jyxddd/open-duck-mini-notes/docs/超声波避障记录.md

# 超声波避障记录

[English version](ultrasonic_obstacle_avoidance.md)

用一个 US-100 超声波测距模块，让 Open Duck 走路时不撞东西。2026-10-27 到 11-03。

## 现状（2026-11-03）

- 超声波装在头上，跟着头转，起步前可以左右看。
- 按住前进键不放，它会按"预判 + 边走边看"自己决定什么时候停下重新看，不再一路走到底。
- 实测：对着 1.9 m 外的墙按住前进，两次都没撞上。第一版停得太远（离墙约 40～50 cm），晚上测改近后的版本（走到约 20 cm 停下）。

## 硬件

- US-100 用串口模式（背面跳线帽插上），3.3 V 供电，输出也是 3.3 V，可以直接接树莓派，不用分压。
- 接线：VCC → 3.3 V（17 脚），Trig/Tx → GPIO15 RXD（10 脚），Echo/Rx → GPIO14 TXD（8 脚），GND → 25 脚。
- 树莓派要开串口、关掉串口控制台：`/boot/firmware/config.txt` 加 `enable_uart=1`，`cmdline.txt` 删掉 `console=serial0,115200`。
- 协议：9600 波特率，发 `0x55` 回 2 字节距离（毫米）；发 `0x50` 回 1 字节温度（+45）。代码：`robot_mjlab/us100.py`，每秒读 10 次。

## 踩过的坑

1. **VCC 和 GND 接反了**，读回 0 字节。换过来就好了，模块没烧。
2. **近距离有假读数。** 真实 3～10 cm 时，会混进 20 cm、26 cm 的假读数，取中位数时假读数反而赢。解决：`nearest()` 取最近 0.8 秒里第二小的读数，要两个低读数才算数。
3. **经常收不到回声。** 软的（沙发、布）、斜的、细的（桌腿）东西，声波要么被吸收，要么被反射走。11-03 的日志里，走路时常常连续 2～4 秒没有有效读数，站着时最长 50 多秒。**以前把"没读数"当成"前面没东西"，按住前进键会一直走过去撞上。** 这是改成预判的原因。
4. **装在头上只看得到约 0.4 m 高度。** 低矮的东西（拖鞋、门槛）看不到。
5. **停车有惯性。** 从发出停止到真正停下约 0.7 秒，会再走 5～8 cm。

## 现在的逻辑（`robot_mjlab/duck_server.py`）

**近距离保护（一直生效，边走边转也算）：**

| 参数 | 值 | 作用 |
| --- | --- | --- |
| 减速区 | 60 cm → 15 cm | 速度从 100% 线性降到 60% |
| 停车线 | 15 cm | 连续 0.2 秒都近就停 |
| 锁存 | 0.5 秒 | 读数在停车线附近闪烁时不会又走起来 |
| 解除 | 20 cm | 停下后要大于 20 cm 才允许再前进 |

原地转向不受限制，方便转开。

**起步扫描：** 往前走之前，头依次转向左、右、前，每个方向停 1.3 秒读距离。前方小于 25 cm 就拒绝前进。10 秒内刚扫描过就不再扫。

**预判 + 边走边看（11-03 新加）：** 扫描完记下前方距离，算出"能走多远"＝前方距离 − 20 cm（没回声时按 80 cm 算，一次最多信 1.5 m）。走路时用指令速度累加已走的距离（指令速度比真实速度快，所以估得偏多、停得偏早，偏安全）。以下任一情况就停下重新扫描：

| 条件 | 说明 |
| --- | --- |
| 走完了能走的距离 | 中途没回声时，就靠这一条 |
| 读到前方不到 50 cm，而且比预判近 15 cm 以上 | 突然冒出来的东西；读数和预判对得上（就是那面墙）就接着走近 |
| 方向比扫描时偏了 45° 以上 | 转过弯再直走，之前看到的距离不算数 |

边走边读到更远的空地，就把"能走多远"往后延，所以对着很远的空地它会一直走，不会无故停。

## 测试

单元测试（`_rescan_reason`，9 种情况，余量 20 cm）：

| 情况 | 结果 |
| --- | --- |
| 前方 1.0 m，走路时一直没回声 | 走 0.80 m 停下重看 |
| 扫描时前方没回声，之后也没有 | 走 0.60 m 停下重看 |
| 前方 1.2 m 的墙，边走边读到 | 走 1.0 m（离墙 20 cm）停下重看 |
| 前方 2 m，一直读到 2 m | 不停 |
| 走 0.3 m 后冒出 45 cm 的椅子 | 马上停下重看 |
| 扫描后转过了 60° | 马上重看 |
| 边走边转，没回声，前方 1.0 m | 走 0.80 m 停下重看 |
| 扫描看到 45 cm，走近时读到同一面墙 | 走 0.25 m 停下重看，这时不到 25 cm，不再前进 |
| 前方 1.86 m，中途一个 26 cm 假读数 | 提前停下重看一次（保守，不危险） |

真机（11-03，od13 kp30，木地板，对着墙按住前进 25 秒，两次，都没撞）：

- 第一次：扫描看到 186 cm → 走约 8 秒 → 读到 26 cm 的假回声，提前停下重看（实际约 60 cm）→ 重看前方 98 cm → 走 3.5 秒 → 在 50 cm 处停下重看。
- 第二次：扫描三个方向都没回声 → 按 50 cm 预判起步 → 2～3 秒后读到 1.3 m 的墙，预判延长 → 在 47 cm 处停下重看 → 看到前方 45 cm，没到当时的拒绝线 40 cm → 一走又读到不到 50 cm → **原地反复扫描**。
- 修正：只有读数比预判近 15 cm 以上才算"冒出来的东西"；余量 30 → 20 cm，拒绝线 40 → 25 cm（用户觉得 40 cm 停得太远）。修正版的单元测试见上表，真机待测。

## 还可以改进

- 用预判过滤假读数：读数比预判的剩余距离突然近很多、又落在 20～26 cm，可以先当可疑，再读几次确认。
- 屋里自己溜达：扫描 → 选最空的方向 → 原地转过去 → 带预判往前走 → 被挡住再扫描。不需要后退，原地转身就能离开。
- 低矮障碍要另加传感器，比如脚前方再装一个小测距模块。
