jyxddd/open-duck-mini-notes/cad/symmetric_legs/knee_cradle_R_sym.stl

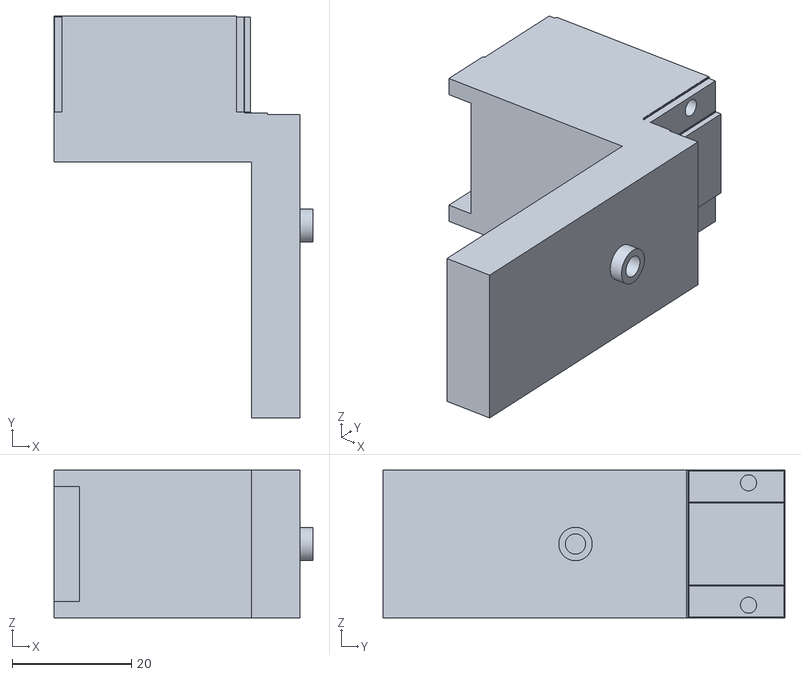
[picture p2: CAD file, 2026-11-14]
cad/symmetric_legs/knee_cradle_R_sym.stl
43.4 x 67.3 x 24.8
