jyxddd/open-duck-mini-notes/cad/symmetric_legs/foot_side_R_mirror.stl

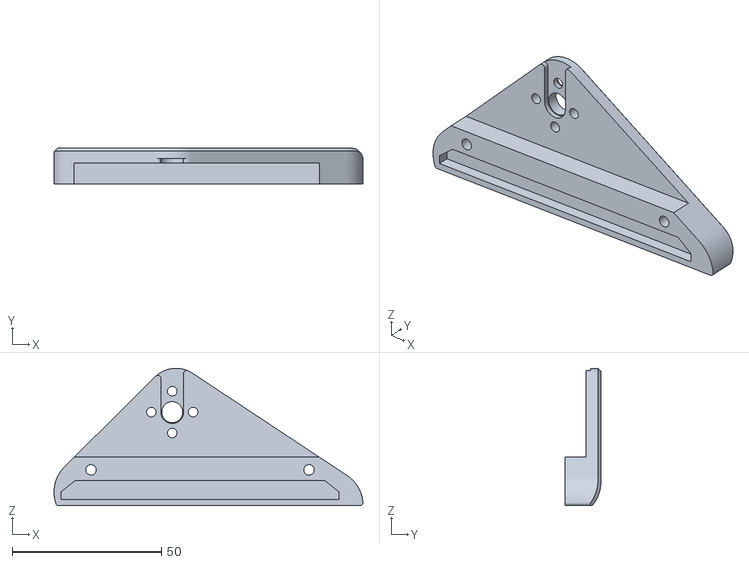
[picture p4: CAD file, 2026-11-14]
cad/symmetric_legs/foot_side_R_mirror.stl
103.5 x 12.0 x 46.0
