jyxddd/open-duck-mini-notes/cad/symmetric_legs/foot_top_R_mirror_slot.stl

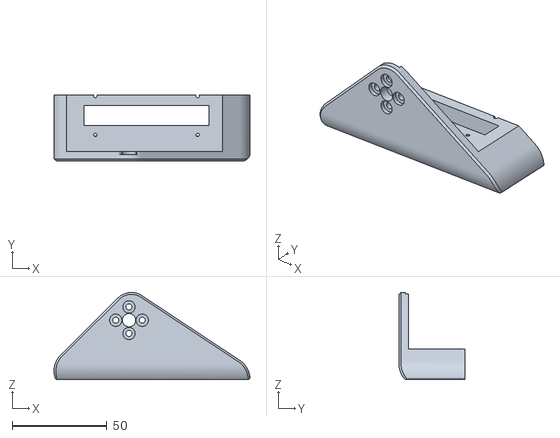
[picture p5: CAD file, 2026-11-14]
cad/symmetric_legs/foot_top_R_mirror_slot.stl
103.5 x 34.9 x 46.0
