jyxddd/open-duck-mini-notes/(list of files, cad)

Other CAD files:
cad/symmetric_legs/foot_top_R_mirror.stl
