jyxddd/open-duck-mini-notes/(commit log)

2026-10-25 Open Duck Mini v2 组装与调试笔记和工具
    - docs: 从零件到稳定行走的问题记录（原因、解决办法、数据对比）
    - robot: 键盘遥控行走（摔倒保护、陀螺仪保持方向、数据记录）、站立、电池保护
    - tools: 舵机寄存器/校准/测试工具、行走数据分析器、MuJoCo 对比实验
    - training: 按真机参数重新训练的补丁
    - windows: 一键启动行走和关机
    [analyze_walk.py, battery_guard.py, bus_test.py, clear_speed.py, fall_guard.py, imu_check.py, imu_glitch_test.py]
2026-11-01 Add the Microduck port record, code and video plan
    Problems and fixes from od1 to od11, sit/stand, XiaoZhi voice, the camera plan.
    [duck_server.py, duck_test_suite.py, fall_guard.py, mjlab_sim_check.py, mjlab_walk.py]
2026-11-03 Add squat and sonar records, per-model kp, look-ahead obstacle scan
    - docs: sit1-sit9 squat history and real results; US-100 sonar record
    - duck_server: look-ahead budget from the walk-start scan, rescans on a run-out
    budget, a surprise reading or a new heading; per-model leg kp (od13 kp30);
    side drive command; model list trimmed
    - mjlab_walk: set_leg_kp; tools: stand_sine_test.py, sim check walk<->sit switch
2026-11-08 Bilingual notes: English versions of all records, new voice/speaker retrofit record, bilingual README
    Also updates robot_mjlab/duck_server.py (30 deg down scan, scan budget fix) and
    xiaozhi_bridge.py (squat / stand-up voice tools, distance in status).
    [duck_server.py, xiaozhi_bridge.py]
2026-11-14 Add symmetric legs retrofit record (mirrored right knee + ankle): fixes sideways drift and turn imbalance
    Bilingual notes, right knee cradle and mirrored right foot STLs with their scripts,
    horn-side play sim tools and the leg symmetry checks.
    [foot_side_R_mirror.stl, foot_side_R_mirror_slot.stl, foot_top_R_mirror.stl, foot_top_R_mirror_slot.stl, knee_cradle_R_sym.stl]
